Glitchyi/keybaord/design/concepts/navy-lighting-v4-usb-flush/rear-usb-flush-closeup.png

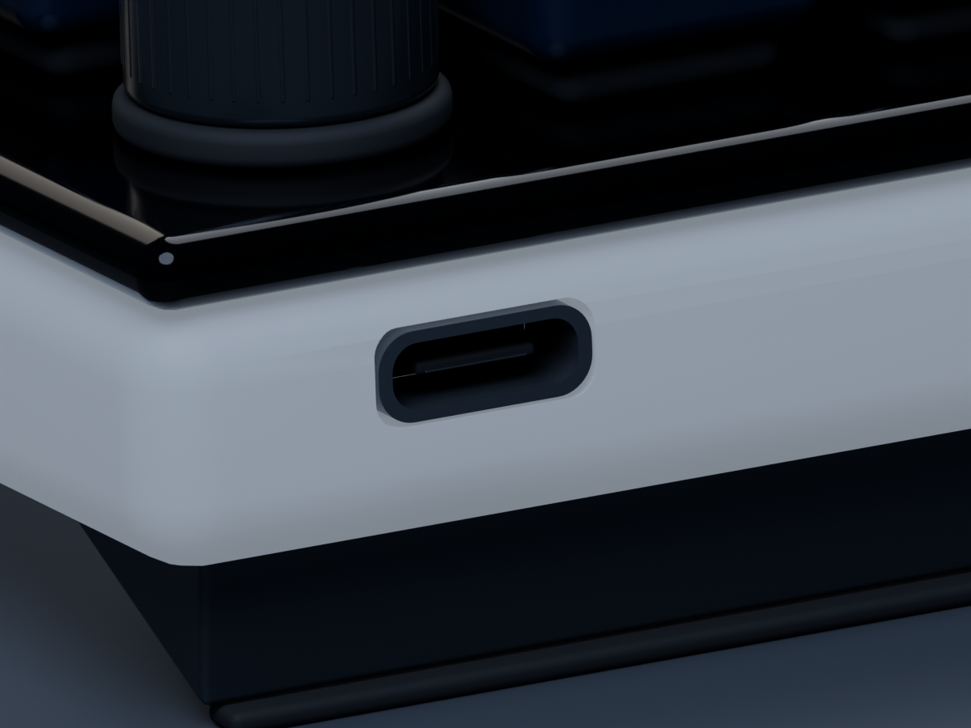
design/concepts/navy-lighting-v4-usb-flush/rear-usb-flush-closeup.png
