Glitchyi/keybaord/design/concepts/navy-lighting-v4/navy-lighting-v4.png

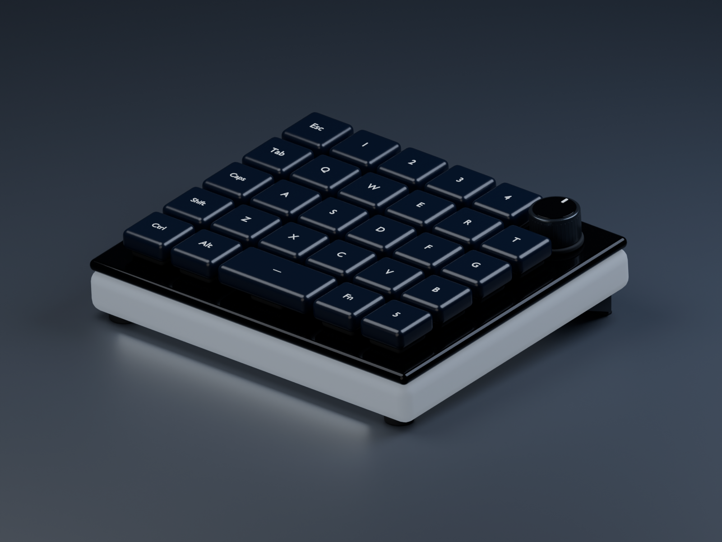
design/concepts/navy-lighting-v4/navy-lighting-v4.png
