Glitchyi/keybaord/design/fit-v1/rear-usb.png

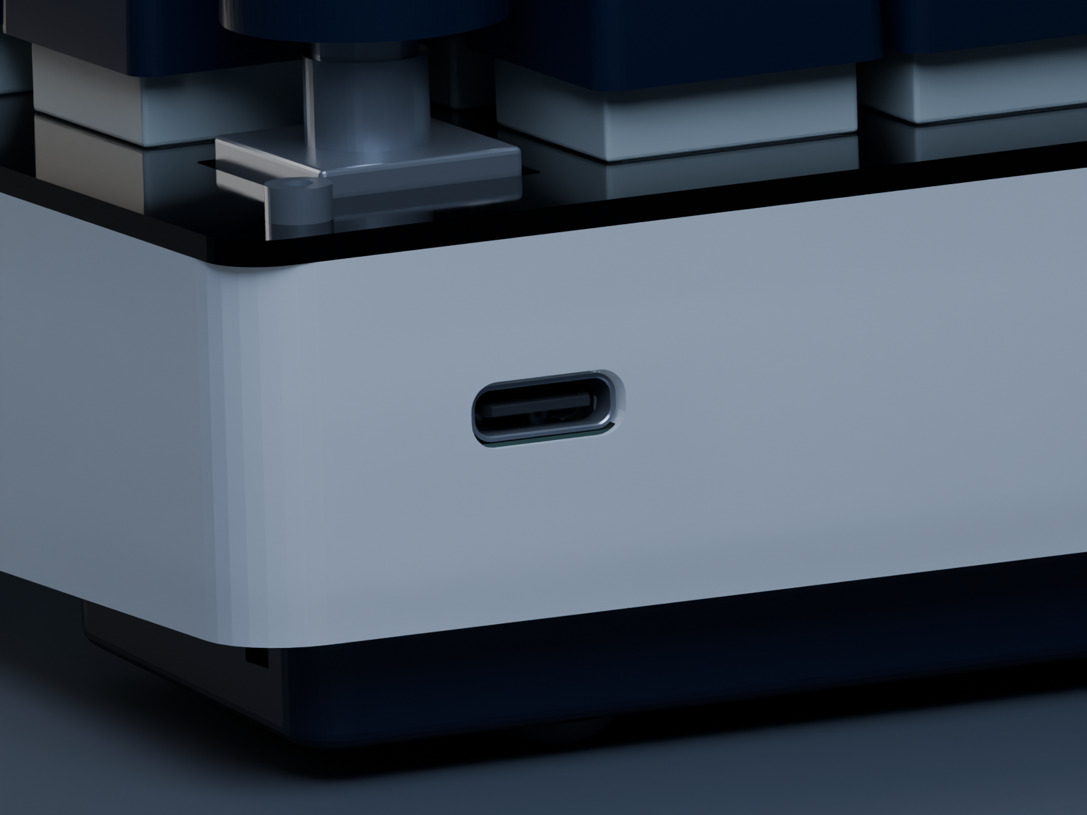
design/fit-v1/rear-usb.png
