Glitchyi/keybaord/design/fit-v1/section.png

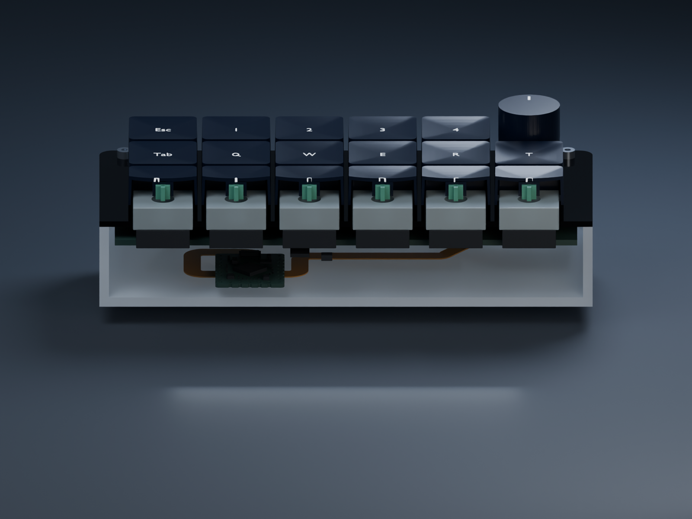
design/fit-v1/section.png
