Glitchyi/keybaord/design/fit-v1/underside.png

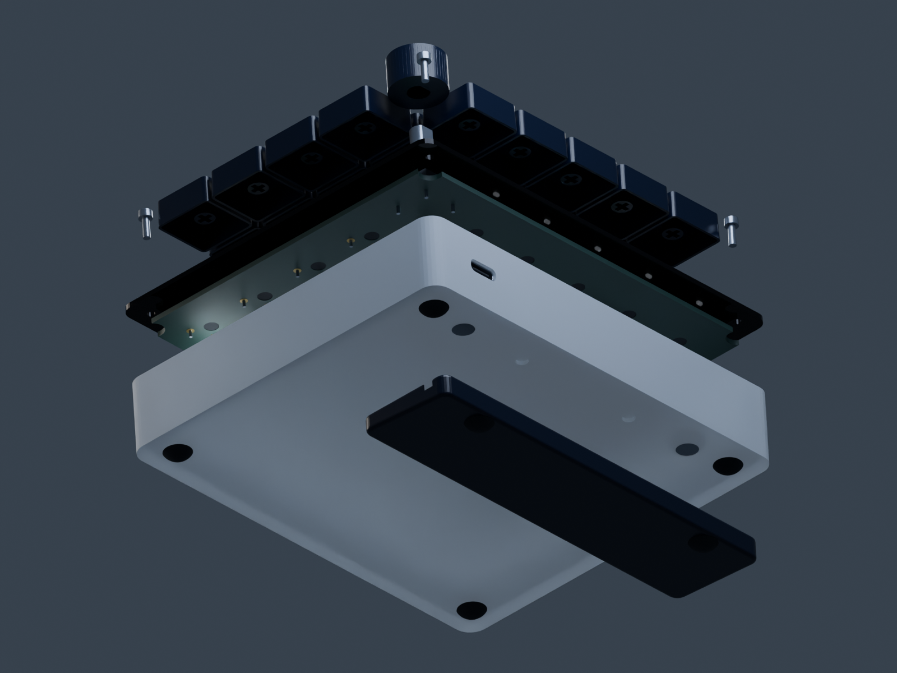
design/fit-v1/underside.png
