Glitchyi/keybaord/procurement/evidence/robu-four-models-2026-10-18.png

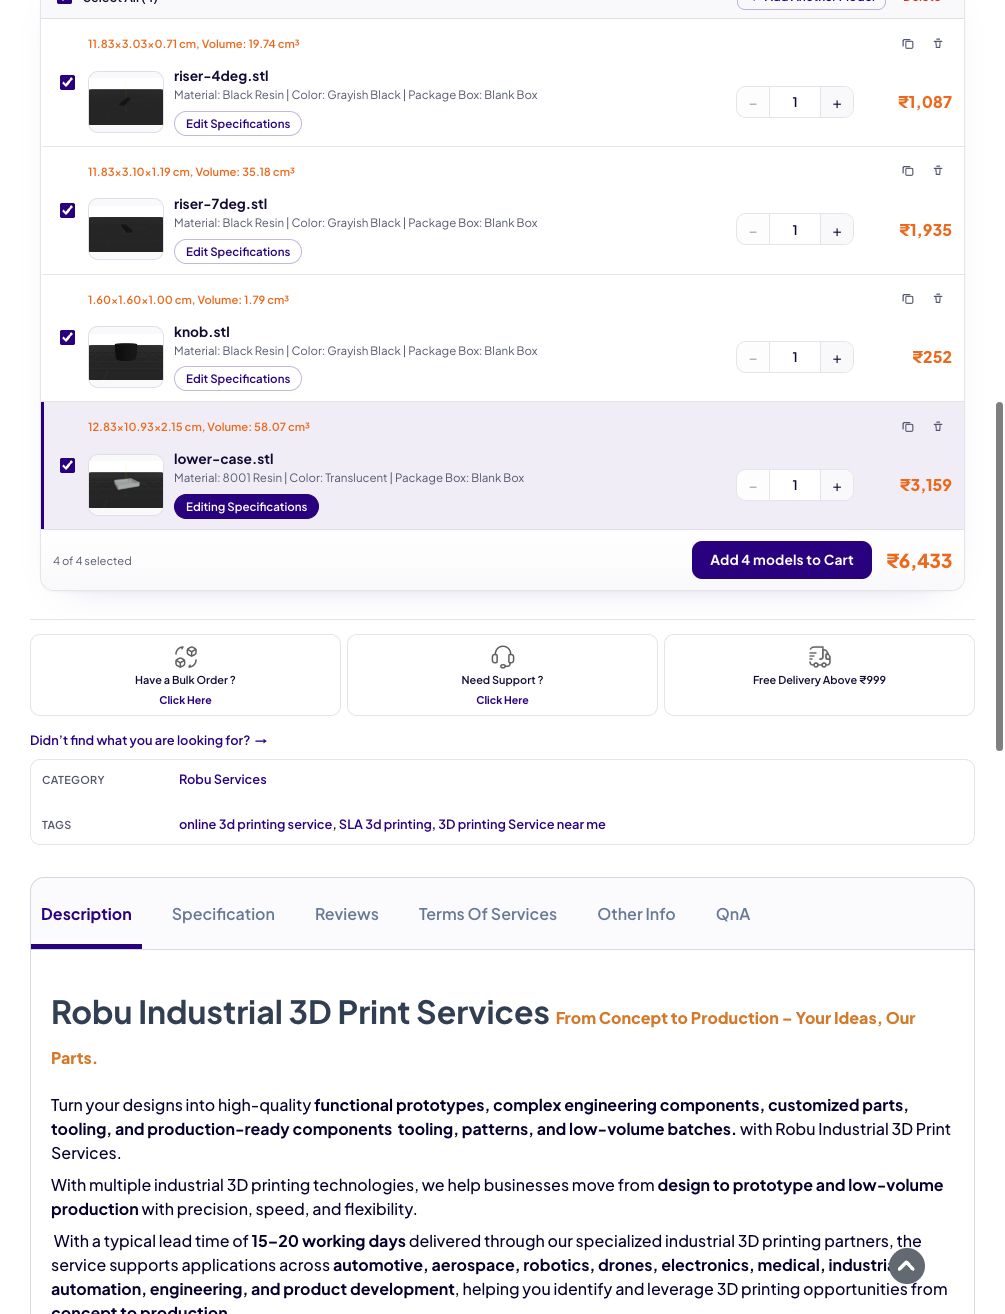
procurement/evidence/robu-four-models-2026-10-18.png
