Glitchyi/keybaord/docs/full-keyboard-cost-audit.md

# Full keyboard cost audit — 18 October 2026

The working-keyboard bill is **incomplete**. Budget **one 4° riser provisionally**, preserve the 7° model/quote as an alternative, and exclude its cost from the selected build. This procurement selection does not revise the frozen dimensional model or its historical BOM. No purchase, substitution, physical-fit or diffusion approval follows from this audit.

## Amounts currently supported

| Scope | Amount, INR | Evidence and limitation |
| --- | ---: | --- |
| Lower case, translucent SLA | 3,159 | Robu live calculator, GST included; heavy frosting and manufacturing changes excluded. |
| Knob, black SLA | 252 | Robu live calculator, GST included; navy finish/index and fit review excluded. |
| **One 4° riser body**, black SLA | **1,087** | Robu live calculator, GST included; magnets, feet and positive capture pieces excluded. |
| **Selected three-print estimate** | **4,498** | Sum of the three rows above; excludes delivery and the unquoted lines below. |
| 7° riser body, alternative only | 1,935 | Keep as an alternative. Selecting it instead gives a three-print estimate of ₹5,346; never count both in a one-riser build. |
| 30 BOX Jade switches, three ten-packs | 840 | Meckeys rechecked today: ₹280 per ten-pack, GST included, in stock. 28 installed, two spares; consumed value ₹784, spare value ₹56. |
| **Selected prints plus switch purchase only** | **5,338** | Cross-supplier partial amount including listed GST, excluding all other required costs. **Not a working-keyboard total or delivered quote.** |
| RP2040-Tiny kit listing | 513.30 | Hubtronics rechecked today: ₹435 +18% GST, **zero stock**. Reference only; availability and delivered procurement cost unresolved. |
| 28 Robu Vishay diodes, packaging alternative | 224 | Earlier actual UI evidence: ₹8 each at 1–49, GST included. Selected BOM is `1N4148W-E3-08`; Robu listing is `-18`. Not an approved substitution; exclude from selected subtotal. |

The four-upload Robu evidence remains ₹6,433 because it records both riser quotations. The new purchasing scope is ₹4,498 for three bodies. Neither amount covers the complete enclosure assembly. See [quote data](../procurement/robu-estimates.json), [actual supplier screenshot](../procurement/evidence/robu-four-models-2026-10-18.png) and [manufacturing findings](robu-quote-status.md). The dynamic calculator results cannot be recovered from an ordinary static product-page fetch; the dated UI capture is the evidence.

Current listing sources: [Robu industrial printing](https://robu.in/product/industrial-3d-printing/), [Meckeys BOX Jade, pack of ten](https://meckeys.com/shop/accessories/keyboard-accessories/key-switches/kailh-box-jade-switch/), [Hubtronics complete Tiny kit](https://hubtronics.in/rp2040-tiny-kit), [Robu diode alternative](https://robu.in/product/1n4148w-e3-18-vishay-1n4148w-e3-18-small-signal-diode-single-100-v-150-ma-1-2-v-4-ns-2-a/). The old ₹1,353.30 component subtotal remains historical evidence; it includes the unavailable kit and must not be mistaken for available stock or added again on top of the ₹840 switch line.

## Required bill for one working keyboard

Quantities below are consumption for one build with one riser. Exact purchased SKUs and design counts come from [the parts contract](../spec/parts.json), [assembly contract](../spec/keypad.json) and [custom-piece export](../procurement/robu/quote-parts.csv). Every unpriced row requires a supplier quote or explicit owner-supplied declaration; unknown does not mean zero.

| Required group | One-build quantity / selection | What the quote still needs |
| --- | --- | --- |
| Clicky switches | 28 Kailh BOX Jade `CPG1511F01S11-1` | ₹840 cash purchase buys 30; delivery and current stock at ordering. Soldered design: no hot-swap sockets required. |
| Keycaps and readable white legends | 27 custom 1u +one custom 2u Space, 28 translucent legend sets | Stem/BOX compatibility sample; viable material/process; dark navy colour and opacity; translucent white legends; finishing, bonding/assembly and rejects. Price the finished set, not 28 uncoloured shells alone. |
| Space stabilizer | One complete CHERRY `G99-0742` 2u mechanism | Exact matching housings, stems, wire and mounting method; availability/pack quantity, assembly and lubrication if used. No generic replacement approved. |
| Glossy top/support plate | One 1.5 mm plate, mirror black finish | Material and cutting process, switch-hole tolerances/edge finish, coating/polishing and flatness. Lower-case quote excludes this plate. |
| Lower case and knob | One each | Existing calculator body estimates only; redesign and final dimensions/process acceptance, heavy-frost treatment, navy knob finish and white index, fit samples. |
| Riser attachment and desk contacts | One 4° body; **four magnets**, **six rubber feet**, **four positive magnet closures** | Two case magnets +two bar magnets; four case feet +two bar feet. Selected references: K&J D42 and 3M SJ5302. Quote closures after redesign; existing thin capture rings are not manufacturing-ready. |
| Structural/USB retention | Six M2×6 screws +six M2 nuts; two USB retaining clamps | Four enclosure screws +two external USB clamp screws. Confirm final stack/length, nut capture and clamp material; include adhesives/insulation where the released design needs them. Do not invent holes through the adapter board. |
| Controller and internal USB link | One Waveshare RP2040-Tiny V1.1 **kit** | Main module, remote USB-C board and supplied approximately 150 mm eight-pin FPC are already included in the kit listing; do not buy/charge them twice. Confirm actual stock and included contents. |
| Encoder | One Bourns `PEC11R-4215F-S0024` | Exact shaft/push variant, distributor MOQ/cut-tape and any required securing hardware. Knob is a separate custom body. |
| Matrix diodes | 28 Vishay `1N4148W-E3-08` | Selected suffix stock, small-quantity packaging and spares. Keep ₹224 Robu `-18` listing as an alternative pending review. |
| White per-key lights | 28 Kingbright `APT1608QWF/D` +one Lumissil `IS31FL3236-QFLS2-TR` | Exact package stock/MOQ, support circuit, soldering and optical samples. This baseline has white per-key PWM, with RGB ambient lighting; per-key RGB is a separate unquoted variant. |
| Ambient lighting and data interface | 14 installed pixels from Adafruit 2969 +one TI `SN74AHCT1G125DBVR` | Purchased strip is one 1 m reel, not only the approximately 97.22 mm consumed segment. Quote connectors/pigtails, wire, insulation and attachment. No delivered INR strip quote yet. |
| Supporting electronics | Values/counts not yet released | LED-driver current-setting resistor, I²C pullups, bypass/bulk capacitors, buffer decoupling and enable bias; RGB data resistor and suitable power buffering; encoder input filtering if needed. Do not add 28 arbitrary LED resistors to a constant-current-driver circuit. |
| Power and external USB | One **data-capable** USB-C cable; protection and power components after review | Verify plug overmould against flush port, USB-C CC behaviour on the existing adapter, ESD/TVS coverage, VBUS current limiting/fusing, inrush, suspend and backfeed handling. Check existing module schematic before adding duplicate parts. Do not assume an external supply or USB-PD board is required. |
| Custom PCB and assembly | One populated keyboard PCB installed; purchased batch unknown | Complete schematic/routing, released Gerbers/drill files, BOM and placement file; fab minimum quantity, exact 1.5 mm stack, finish, stencil, sourcing, assembly setup/labour, inspection/rework and electrical testing. No PCB price is established. |
| Firmware and Windows volume sync | One tested firmware build +helper | Matrix/debounce, encoder/modifiers, remapping/macros/profile persistence, independent white brightness/effects, ambient/current limit, USB boot/recovery, host volume/mute sync and reconnect/default-device handling. Engineering effort or commissioned cost is unquoted, not zero. |
| Bring-up, samples and delivery | Per prototype programme | Socket/plate, stabilizer, port/clamp, magnetic-joint and diffuser coupons; solder/reflow supplies, tools or assembly service, light/current measurements, iteration/reprints, packing, supplier freight and any import/clearance charges. |

## Critical decisions before a firm total

1. **Close electronics and power before PCB release.** The selected driver has 36 independently controlled constant-current PWM channels; its external current-setting resistor and support circuit belong in the BOM. Its Rev H revision history records an **NRND watermark** added in 2021: obtain lifecycle/stock confirmation and review suitability before release, without silently changing the part. The manufacturer's reel quantity is not a one-off distributor MOQ. [Lumissil datasheet, application circuit, ordering information and revision history](https://www.lumissil.com/assets/pdf/core/IS31FL3236_DS.pdf).
2. **Set a usable USB lighting limit.** Adafruit specifies up to 60 mA per pixel for this strip. Fourteen pixels therefore give a conservative **840 mA strip-only maximum**, before white keys/controller. This arithmetic is a power-design warning, not measured use; define brightness/current limiting and verify the actual port/cable budget. The strip guide also identifies data resistance, buffering and level shifting; final component values/volume must suit this small enclosure. [Strip specification](https://www.adafruit.com/product/2969), [wiring practices](https://learn.adafruit.com/adafruit-neopixel-uberguide/best-practices), [selected TI buffer](https://www.ti.com/product/SN74AHCT1G125).
3. **Quote a manufacture-ready revision.** Existing caps, USB skin, nut-trap walls, clamps/capture rings and material interfaces need review/redesign; frozen geometry is a cost study. Validate samples for full switch travel, stem fit, 2u movement, retention and diffusion. Robu publishes process guidance, but a calculator price does not accept these interfaces. [Local manufacturing audit](../procurement/robu/README.md), [Robu printing guide](https://robu.in/3d-printing-guide/).
4. **Resolve PCB thickness and files.** Recorded Robu calculator refused a price without Gerbers and offered 1.6 mm rather than the model's 1.5 mm. Ask for the selected stack or revalidate the stabilizer/mechanical stack before accepting an alternative. Quote the actual batch separately from one-board consumption. [Recorded calculator result](robu-quote-status.md), [Robu PCB service](https://robu.in/product/online-pcb-manufacturing-service/).
5. **Count software as delivery work.** QMK Raw HID supports bidirectional host communication and requires a host program; Windows endpoint-volume callbacks can supply real volume changes. This supports the accepted helper approach but is not implemented keyboard firmware or a tested Windows app. [QMK Raw HID](https://docs.qmk.fm/features/rawhid), [Microsoft endpoint volume notifications](https://learn.microsoft.com/en-us/windows/win32/coreaudio/endpoint-volume-controls).

## Purchase-budget rules and quote completion

Keep three separate figures: **one-keyboard materials consumed**, **prototype cash spend** (packs/MOQs/spares, complete strip reel, PCB batch, freight and taxes), and **development/validation cost** (engineering, samples, tools and rework). Do not amortize a five-board purchase into one fifth of the money needed to build the first unit. Existing owned tools/materials need an explicit declaration before treating their additional cash spend as zero. No speculative percentage contingency is presented as a supplier quote.

For every unpriced line obtain: exact part/material/revision, installed quantity, purchasable quantity/pack/MOQ, unit and extended INR prices, GST included/excluded, availability, delivery destination/freight, import/clearance if applicable, lead time, assembly/finishing inclusion, quote expiry, and accepted tolerances/DFM exceptions. Add GST once; never apply it again to the Robu/Meckeys inclusive figures. Deduplicate kit contents and supplier/assembly turnkey component charges.

**Optional, separate from the base working-keyboard bill:** profile sheets (forming/tooling, opaque masking and printed icons, knob notch, key-travel trials), per-sheet identification tags and reader/antenna/support circuitry, plus profile-detection firmware. Automatic NFC switching and formed overlays remain concepts. The alternate 7° bar and per-key RGB comparison also remain separate options, not extra mandatory cost. No exact optional hardware or price is selected here.
