Glitchyi/keybaord/procurement/robu-purchased-parts.csv

Manufacturer | MPN | Quantity | Description | Substitution policy
Kailh | CPG1511F01S11-1 | 30 | BOX Jade standard-height soldered clicky switch | Exact code preferred; list any alternative separately for dimensional review
CHERRY | G99-0742 | 1 | 2u PCB-mounted leveling mechanism | Exact code preferred; list any alternative separately for dimensional review
Waveshare | RP2040-Tiny V1.1 | 1 | RP2040-Tiny main controller module | Quote full V1.1 kit including adapter and supplied FPC; do not double charge
Bourns | PEC11R-4215F-S0024 | 1 | Rotary encoder with push switch | Exact code preferred; list any alternative separately for dimensional review
Kingbright | APT1608QWF/D | 28 | Top-emitting white per-key LED | Exact code preferred; list any alternative separately for dimensional review
Lumissil | IS31FL3236-QFLS2-TR | 1 | 36-channel white LED PWM driver | Exact code preferred; list any alternative separately for dimensional review
Adafruit | 2969 | 1 | Base RGB LED strip, white flex PCB | Exact code preferred; list any alternative separately for dimensional review
Texas Instruments | SN74AHCT1G125DBVR | 1 | 5V RGB data logic buffer | Exact code preferred; list any alternative separately for dimensional review
K&J Magnetics | D42 | 4 | Captive riser attachment disc magnet | Exact code preferred; list any alternative separately for dimensional review
3M | SJ5302 / 7100006189 | 6 | Clear hemispherical adhesive contact foot | Exact code preferred; list any alternative separately for dimensional review
RS PRO | 293-280 | 6 | M2 x 6 socket cap enclosure screw | Exact code preferred; list any alternative separately for dimensional review
RS PRO | 248-4551 | 6 | M2 captive hex nut | Exact code preferred; list any alternative separately for dimensional review
Vishay | 1N4148W-E3-08 | 28 | Per-key matrix anti-ghosting diode | Exact code preferred; list any alternative separately for dimensional review
