Glitchyi/keybaord/procurement/robu/quote-parts.csv

id | file | quantity | width_mm | depth_mm | height_mm | volume_mm3 | closed_manifold | components | instant_budgetary_candidate | print_ready | thin_features
lower-case | stl/lower-case.stl | 1 | 128.3000030517578 | 109.25 | 21.5 | 58068.742442588016 | True | 1 | False | False | [{"feature": "rear USB blind-pocket outer skin", "mm": 0.5230941785257641, "kind": "wall", "status": "below-provider-minimum"}, {"feature": "support-post hex nut trap minimum radial wall", "mm": 0.20965881556564625, "kind": "wall", "status": "below-provider-minimum"}]
plate | stl/plate.stl | 1 | 128.3000030517578 | 109.25 | 1.5 | 12117.9266763235 | True | 1 | False | False | [{"feature": "plate thickness", "mm": 1.5, "kind": "wall", "status": "below-size-based-2mm-wall-minimum"}]
riser-4deg | stl/riser-4deg.stl | 1 | 118.30000305175781 | 30.0 | 7.536687850952148 | 19738.783353551342 | True | 1 | True | False | [{"feature": "locating key height", "mm": 0.8, "kind": "raised feature", "status": "at-provider-thinnest-feature-limit"}]
riser-7deg | stl/riser-7deg.stl | 1 | 118.30000305175781 | 30.0 | 12.637569427490234 | 35178.30528715591 | True | 1 | True | False | [{"feature": "locating key height", "mm": 0.8, "kind": "raised feature", "status": "at-provider-thinnest-feature-limit"}]
knob | stl/knob.stl | 1 | 16.040002822875977 | 16.03999900817871 | 10.0 | 1788.228755772041 | True | 1 | False | False | [{"feature": "grip cylinder diameter before union", "mm": 0.24, "kind": "surface detail", "status": "below-provider-thinnest-feature-limit"}, {"feature": "approximate grip proudness after union", "mm": 0.02, "kind": "surface detail", "status": "supplier-detail-review-required"}]
cap-1u-esc | stl/cap-1u-esc.stl | 1 | 18.0 | 18.0 | 7.799999713897705 | 680.1541374379751 | False | 1 | False | False | [{"feature": "nominal side wall", "mm": 0.7, "kind": "wall", "status": "below-provider-minimum"}, {"feature": "nominal boss-to-cross-tip radial wall", "mm": 0.75, "kind": "wall", "status": "below-provider-minimum"}]
legend-esc | stl/legend-esc.stl | 1 | 3.881600022315979 | 2.2112001180648804 | 1.0340137481689453 | 3.01592424188986 | False | 3 | False | False | [{"feature": "glyph stroke minimum", "mm": null, "kind": "surface detail", "status": "not-fully-measured; sub-0.8mm nominal glyph strokes and disconnected islands require redesign or process review"}]
cap-1u-1 | stl/cap-1u-1.stl | 1 | 18.0 | 18.0 | 7.799999713897705 | 682.067935476108 | True | 1 | False | False | [{"feature": "nominal side wall", "mm": 0.7, "kind": "wall", "status": "below-provider-minimum"}, {"feature": "nominal boss-to-cross-tip radial wall", "mm": 0.75, "kind": "wall", "status": "below-provider-minimum"}]
legend-1 | stl/legend-1.stl | 1 | 0.31360001862049103 | 2.182400107383728 | 1.0166683197021484 | 0.6839513521072044 | True | 1 | False | False | [{"feature": "glyph stroke minimum", "mm": null, "kind": "surface detail", "status": "not-fully-measured; sub-0.8mm nominal glyph strokes and disconnected islands require redesign or process review"}]
cap-1u-2 | stl/cap-1u-2.stl | 1 | 18.0 | 18.0 | 7.799999713897705 | 681.6416930399932 | True | 1 | False | False | [{"feature": "nominal side wall", "mm": 0.7, "kind": "wall", "status": "below-provider-minimum"}, {"feature": "nominal boss-to-cross-tip radial wall", "mm": 0.75, "kind": "wall", "status": "below-provider-minimum"}]
legend-2 | stl/legend-2.stl | 1 | 1.3824000358581543 | 2.2112001180648804 | 1.016815185546875 | 1.2079902402960299 | True | 1 | False | False | [{"feature": "glyph stroke minimum", "mm": null, "kind": "surface detail", "status": "not-fully-measured; sub-0.8mm nominal glyph strokes and disconnected islands require redesign or process review"}]
cap-1u-3 | stl/cap-1u-3.stl | 1 | 18.0 | 18.0 | 7.799999713897705 | 681.6701704955516 | False | 1 | False | False | [{"feature": "nominal side wall", "mm": 0.7, "kind": "wall", "status": "below-provider-minimum"}, {"feature": "nominal boss-to-cross-tip radial wall", "mm": 0.75, "kind": "wall", "status": "below-provider-minimum"}]
legend-3 | stl/legend-3.stl | 1 | 1.152000069618225 | 2.2400001287460327 | 1.0170612335205078 | 1.1738812993755259 | False | 1 | False | False | [{"feature": "glyph stroke minimum", "mm": null, "kind": "surface detail", "status": "not-fully-measured; sub-0.8mm nominal glyph strokes and disconnected islands require redesign or process review"}]
cap-1u-4 | stl/cap-1u-4.stl | 1 | 18.0 | 18.0 | 7.799999713897705 | 681.6222310912216 | True | 1 | False | False | [{"feature": "nominal side wall", "mm": 0.7, "kind": "wall", "status": "below-provider-minimum"}, {"feature": "nominal boss-to-cross-tip radial wall", "mm": 0.75, "kind": "wall", "status": "below-provider-minimum"}]
legend-4 | stl/legend-4.stl | 1 | 1.4720000624656677 | 2.2112001180648804 | 1.0170612335205078 | 1.23612593177254 | True | 1 | False | False | [{"feature": "glyph stroke minimum", "mm": null, "kind": "surface detail", "status": "not-fully-measured; sub-0.8mm nominal glyph strokes and disconnected islands require redesign or process review"}]
cap-1u-tab | stl/cap-1u-tab.stl | 1 | 18.0 | 18.0 | 7.799999713897705 | 679.866522979043 | True | 1 | False | False | [{"feature": "nominal side wall", "mm": 0.7, "kind": "wall", "status": "below-provider-minimum"}, {"feature": "nominal boss-to-cross-tip radial wall", "mm": 0.75, "kind": "wall", "status": "below-provider-minimum"}]
legend-tab | stl/legend-tab.stl | 1 | 4.736000061035156 | 2.2112001180648804 | 1.0477237701416016 | 3.3554368561610906 | True | 3 | False | False | [{"feature": "glyph stroke minimum", "mm": null, "kind": "surface detail", "status": "not-fully-measured; sub-0.8mm nominal glyph strokes and disconnected islands require redesign or process review"}]
cap-1u-q | stl/cap-1u-q.stl | 1 | 18.0 | 18.0 | 7.799999713897705 | 680.9428715990439 | True | 1 | False | False | [{"feature": "nominal side wall", "mm": 0.7, "kind": "wall", "status": "below-provider-minimum"}, {"feature": "nominal boss-to-cross-tip radial wall", "mm": 0.75, "kind": "wall", "status": "below-provider-minimum"}]
legend-q | stl/legend-q.stl | 1 | 2.253968596458435 | 2.653970718383789 | 1.015726089477539 | 2.0665585156953146 | True | 1 | False | False | [{"feature": "glyph stroke minimum", "mm": null, "kind": "surface detail", "status": "not-fully-measured; sub-0.8mm nominal glyph strokes and disconnected islands require redesign or process review"}]
cap-1u-w | stl/cap-1u-w.stl | 1 | 18.0 | 18.0 | 7.799999713897705 | 680.7621568464621 | True | 1 | False | False | [{"feature": "nominal side wall", "mm": 0.7, "kind": "wall", "status": "below-provider-minimum"}, {"feature": "nominal boss-to-cross-tip radial wall", "mm": 0.75, "kind": "wall", "status": "below-provider-minimum"}]
legend-w | stl/legend-w.stl | 1 | 3.3312000036239624 | 2.201600134372711 | 1.019230842590332 | 2.285960918970504 | True | 1 | False | False | [{"feature": "glyph stroke minimum", "mm": null, "kind": "surface detail", "status": "not-fully-measured; sub-0.8mm nominal glyph strokes and disconnected islands require redesign or process review"}]
cap-1u-e | stl/cap-1u-e.stl | 1 | 18.0 | 18.0 | 7.799999713897705 | 681.4350700275222 | True | 1 | False | False | [{"feature": "nominal side wall", "mm": 0.7, "kind": "wall", "status": "below-provider-minimum"}, {"feature": "nominal boss-to-cross-tip radial wall", "mm": 0.75, "kind": "wall", "status": "below-provider-minimum"}]
legend-e | stl/legend-e.stl | 1 | 1.2672000527381897 | 2.182400107383728 | 1.0166683197021484 | 1.4635906341940783 | True | 1 | False | False | [{"feature": "glyph stroke minimum", "mm": null, "kind": "surface detail", "status": "not-fully-measured; sub-0.8mm nominal glyph strokes and disconnected islands require redesign or process review"}]
cap-1u-r | stl/cap-1u-r.stl | 1 | 18.0 | 18.0 | 7.799999713897705 | 681.2685738867676 | True | 1 | False | False | [{"feature": "nominal side wall", "mm": 0.7, "kind": "wall", "status": "below-provider-minimum"}, {"feature": "nominal boss-to-cross-tip radial wall", "mm": 0.75, "kind": "wall", "status": "below-provider-minimum"}]
legend-r | stl/legend-r.stl | 1 | 1.6864001154899597 | 2.182400107383728 | 1.0166683197021484 | 1.6707669657692252 | True | 1 | False | False | [{"feature": "glyph stroke minimum", "mm": null, "kind": "surface detail", "status": "not-fully-measured; sub-0.8mm nominal glyph strokes and disconnected islands require redesign or process review"}]
cap-1u-t | stl/cap-1u-t.stl | 1 | 18.0 | 18.0 | 7.799999713897705 | 681.7213979588009 | True | 1 | False | False | [{"feature": "nominal side wall", "mm": 0.7, "kind": "wall", "status": "below-provider-minimum"}, {"feature": "nominal boss-to-cross-tip radial wall", "mm": 0.75, "kind": "wall", "status": "below-provider-minimum"}]
legend-t | stl/legend-t.stl | 1 | 1.8240001201629639 | 2.182400107383728 | 1.0166683197021484 | 1.1087397911525652 | True | 1 | False | False | [{"feature": "glyph stroke minimum", "mm": null, "kind": "surface detail", "status": "not-fully-measured; sub-0.8mm nominal glyph strokes and disconnected islands require redesign or process review"}]
cap-1u-caps | stl/cap-1u-caps.stl | 1 | 18.0 | 18.0 | 7.799999713897705 | 680.0088977870846 | True | 1 | False | False | [{"feature": "nominal side wall", "mm": 0.7, "kind": "wall", "status": "below-provider-minimum"}, {"feature": "nominal boss-to-cross-tip radial wall", "mm": 0.75, "kind": "wall", "status": "below-provider-minimum"}]
legend-caps | stl/legend-caps.stl | 1 | 5.216400384902954 | 2.486700177192688 | 1.0591402053833008 | 3.160630848309758 | True | 4 | False | False | [{"feature": "glyph stroke minimum", "mm": null, "kind": "surface detail", "status": "not-fully-measured; sub-0.8mm nominal glyph strokes and disconnected islands require redesign or process review"}]
cap-1u-a | stl/cap-1u-a.stl | 1 | 18.0 | 18.0 | 7.799999713897705 | 681.3776001577571 | True | 1 | False | False | [{"feature": "nominal side wall", "mm": 0.7, "kind": "wall", "status": "below-provider-minimum"}, {"feature": "nominal boss-to-cross-tip radial wall", "mm": 0.75, "kind": "wall", "status": "below-provider-minimum"}]
legend-a | stl/legend-a.stl | 1 | 2.1344001293182373 | 2.195200204849243 | 1.0163211822509766 | 1.5368594594326923 | True | 1 | False | False | [{"feature": "glyph stroke minimum", "mm": null, "kind": "surface detail", "status": "not-fully-measured; sub-0.8mm nominal glyph strokes and disconnected islands require redesign or process review"}]
cap-1u-s | stl/cap-1u-s.stl | 1 | 18.0 | 18.0 | 7.799999713897705 | 681.6233228068354 | True | 1 | False | False | [{"feature": "nominal side wall", "mm": 0.7, "kind": "wall", "status": "below-provider-minimum"}, {"feature": "nominal boss-to-cross-tip radial wall", "mm": 0.75, "kind": "wall", "status": "below-provider-minimum"}]
legend-s | stl/legend-s.stl | 1 | 1.2352001070976257 | 2.2400001287460327 | 1.0170612335205078 | 1.2316331088572168 | True | 1 | False | False | [{"feature": "glyph stroke minimum", "mm": null, "kind": "surface detail", "status": "not-fully-measured; sub-0.8mm nominal glyph strokes and disconnected islands require redesign or process review"}]
cap-1u-d | stl/cap-1u-d.stl | 1 | 18.0 | 18.0 | 7.799999713897705 | 681.0621021248455 | True | 1 | False | False | [{"feature": "nominal side wall", "mm": 0.7, "kind": "wall", "status": "below-provider-minimum"}, {"feature": "nominal boss-to-cross-tip radial wall", "mm": 0.75, "kind": "wall", "status": "below-provider-minimum"}]
legend-d | stl/legend-d.stl | 1 | 2.0096001625061035 | 2.182400107383728 | 1.0095062255859375 | 1.91802956997474 | True | 1 | False | False | [{"feature": "glyph stroke minimum", "mm": null, "kind": "surface detail", "status": "not-fully-measured; sub-0.8mm nominal glyph strokes and disconnected islands require redesign or process review"}]
cap-1u-f | stl/cap-1u-f.stl | 1 | 18.0 | 18.0 | 7.799999713897705 | 681.6792822152082 | True | 1 | False | False | [{"feature": "nominal side wall", "mm": 0.7, "kind": "wall", "status": "below-provider-minimum"}, {"feature": "nominal boss-to-cross-tip radial wall", "mm": 0.75, "kind": "wall", "status": "below-provider-minimum"}]
legend-f | stl/legend-f.stl | 1 | 1.1648001074790955 | 2.182400107383728 | 1.0158624649047852 | 1.1629103996072132 | True | 1 | False | False | [{"feature": "glyph stroke minimum", "mm": null, "kind": "surface detail", "status": "not-fully-measured; sub-0.8mm nominal glyph strokes and disconnected islands require redesign or process review"}]
cap-1u-g | stl/cap-1u-g.stl | 1 | 18.0 | 18.0 | 7.799999713897705 | 681.1816223405955 | True | 1 | False | False | [{"feature": "nominal side wall", "mm": 0.7, "kind": "wall", "status": "below-provider-minimum"}, {"feature": "nominal boss-to-cross-tip radial wall", "mm": 0.75, "kind": "wall", "status": "below-provider-minimum"}]
legend-g | stl/legend-g.stl | 1 | 1.9936001896858215 | 2.2400001287460327 | 1.0135536193847656 | 1.7718920526419626 | True | 1 | False | False | [{"feature": "glyph stroke minimum", "mm": null, "kind": "surface detail", "status": "not-fully-measured; sub-0.8mm nominal glyph strokes and disconnected islands require redesign or process review"}]
cap-1u-shift | stl/cap-1u-shift.stl | 1 | 18.0 | 18.0 | 7.799999713897705 | 680.0453637187546 | True | 1 | False | False | [{"feature": "nominal side wall", "mm": 0.7, "kind": "wall", "status": "below-provider-minimum"}, {"feature": "nominal boss-to-cross-tip radial wall", "mm": 0.75, "kind": "wall", "status": "below-provider-minimum"}]
legend-shift | stl/legend-shift.stl | 1 | 4.641300201416016 | 1.891100287437439 | 1.0490894317626953 | 3.136192671094232 | True | 6 | False | False | [{"feature": "glyph stroke minimum", "mm": null, "kind": "surface detail", "status": "not-fully-measured; sub-0.8mm nominal glyph strokes and disconnected islands require redesign or process review"}]
cap-1u-z | stl/cap-1u-z.stl | 1 | 18.0 | 18.0 | 7.799999713897705 | 681.2989623233683 | True | 1 | False | False | [{"feature": "nominal side wall", "mm": 0.7, "kind": "wall", "status": "below-provider-minimum"}, {"feature": "nominal boss-to-cross-tip radial wall", "mm": 0.75, "kind": "wall", "status": "below-provider-minimum"}]
legend-z | stl/legend-z.stl | 1 | 1.9680001735687256 | 2.182400107383728 | 1.0166683197021484 | 1.6293615222010742 | True | 1 | False | False | [{"feature": "glyph stroke minimum", "mm": null, "kind": "surface detail", "status": "not-fully-measured; sub-0.8mm nominal glyph strokes and disconnected islands require redesign or process review"}]
cap-1u-x | stl/cap-1u-x.stl | 1 | 18.0 | 18.0 | 7.799999713897705 | 681.3564509641292 | True | 1 | False | False | [{"feature": "nominal side wall", "mm": 0.7, "kind": "wall", "status": "below-provider-minimum"}, {"feature": "nominal boss-to-cross-tip radial wall", "mm": 0.75, "kind": "wall", "status": "below-provider-minimum"}]
legend-x | stl/legend-x.stl | 1 | 2.2528001070022583 | 2.182400107383728 | 1.0167427062988281 | 1.5626141437251997 | True | 1 | False | False | [{"feature": "glyph stroke minimum", "mm": null, "kind": "surface detail", "status": "not-fully-measured; sub-0.8mm nominal glyph strokes and disconnected islands require redesign or process review"}]
cap-1u-c | stl/cap-1u-c.stl | 1 | 18.0 | 18.0 | 7.799999713897705 | 681.4572156866587 | True | 1 | False | False | [{"feature": "nominal side wall", "mm": 0.7, "kind": "wall", "status": "below-provider-minimum"}, {"feature": "nominal boss-to-cross-tip radial wall", "mm": 0.75, "kind": "wall", "status": "below-provider-minimum"}]
legend-c | stl/legend-c.stl | 1 | 1.9680001735687256 | 2.2400001287460327 | 1.0103569030761719 | 1.4319431917388212 | True | 1 | False | False | [{"feature": "glyph stroke minimum", "mm": null, "kind": "surface detail", "status": "not-fully-measured; sub-0.8mm nominal glyph strokes and disconnected islands require redesign or process review"}]
cap-1u-v | stl/cap-1u-v.stl | 1 | 18.0 | 18.0 | 7.799999713897705 | 681.65509482699 | True | 1 | False | False | [{"feature": "nominal side wall", "mm": 0.7, "kind": "wall", "status": "below-provider-minimum"}, {"feature": "nominal boss-to-cross-tip radial wall", "mm": 0.75, "kind": "wall", "status": "below-provider-minimum"}]
legend-v | stl/legend-v.stl | 1 | 1.9328001737594604 | 2.201600134372711 | 1.0152912139892578 | 1.1942127790083028 | True | 1 | False | False | [{"feature": "glyph stroke minimum", "mm": null, "kind": "surface detail", "status": "not-fully-measured; sub-0.8mm nominal glyph strokes and disconnected islands require redesign or process review"}]
cap-1u-b | stl/cap-1u-b.stl | 1 | 18.0 | 18.0 | 7.799999713897705 | 681.1013525729745 | True | 1 | False | False | [{"feature": "nominal side wall", "mm": 0.7, "kind": "wall", "status": "below-provider-minimum"}, {"feature": "nominal boss-to-cross-tip radial wall", "mm": 0.75, "kind": "wall", "status": "below-provider-minimum"}]
legend-b | stl/legend-b.stl | 1 | 1.4976001381874084 | 2.182400107383728 | 1.0165739059448242 | 1.8760849660474328 | True | 1 | False | False | [{"feature": "glyph stroke minimum", "mm": null, "kind": "surface detail", "status": "not-fully-measured; sub-0.8mm nominal glyph strokes and disconnected islands require redesign or process review"}]
cap-1u-ctrl | stl/cap-1u-ctrl.stl | 1 | 18.0 | 18.0 | 7.799999713897705 | 680.6567387519121 | True | 1 | False | False | [{"feature": "nominal side wall", "mm": 0.7, "kind": "wall", "status": "below-provider-minimum"}, {"feature": "nominal boss-to-cross-tip radial wall", "mm": 0.75, "kind": "wall", "status": "below-provider-minimum"}]
legend-ctrl | stl/legend-ctrl.stl | 1 | 4.166100263595581 | 1.8900001049041748 | 1.0381536483764648 | 2.393544908292756 | True | 4 | False | False | [{"feature": "glyph stroke minimum", "mm": null, "kind": "surface detail", "status": "not-fully-measured; sub-0.8mm nominal glyph strokes and disconnected islands require redesign or process review"}]
cap-1u-alt | stl/cap-1u-alt.stl | 1 | 18.0 | 18.0 | 7.799999713897705 | 680.2755471142219 | True | 1 | False | False | [{"feature": "nominal side wall", "mm": 0.7, "kind": "wall", "status": "below-provider-minimum"}, {"feature": "nominal boss-to-cross-tip radial wall", "mm": 0.75, "kind": "wall", "status": "below-provider-minimum"}]
legend-alt | stl/legend-alt.stl | 1 | 3.897600293159485 | 2.2240002155303955 | 1.0292377471923828 | 2.876550506503566 | True | 3 | False | False | [{"feature": "glyph stroke minimum", "mm": null, "kind": "surface detail", "status": "not-fully-measured; sub-0.8mm nominal glyph strokes and disconnected islands require redesign or process review"}]
cap-2u-space | stl/cap-2u-space.stl | 1 | 37.04999923706055 | 18.0 | 7.799999713897705 | 1333.38315736413 | True | 1 | False | False | [{"feature": "nominal side wall", "mm": 0.7, "kind": "wall", "status": "below-provider-minimum"}, {"feature": "nominal boss-to-cross-tip radial wall", "mm": 0.75, "kind": "wall", "status": "below-provider-minimum"}]
legend-space | stl/legend-space.stl | 1 | 3.2576003074645996 | 0.20480003207921982 | 1.0099544525146484 | 0.666995535873118 | True | 1 | False | False | [{"feature": "glyph stroke minimum", "mm": null, "kind": "surface detail", "status": "not-fully-measured; sub-0.8mm nominal glyph strokes and disconnected islands require redesign or process review"}]
cap-1u-fn | stl/cap-1u-fn.stl | 1 | 18.0 | 18.0 | 7.799999713897705 | 680.9178309690748 | True | 1 | False | False | [{"feature": "nominal side wall", "mm": 0.7, "kind": "wall", "status": "below-provider-minimum"}, {"feature": "nominal boss-to-cross-tip radial wall", "mm": 0.75, "kind": "wall", "status": "below-provider-minimum"}]
legend-fn | stl/legend-fn.stl | 1 | 2.6624001264572144 | 2.182400107383728 | 1.0163698196411133 | 2.0931713798188696 | True | 2 | False | False | [{"feature": "glyph stroke minimum", "mm": null, "kind": "surface detail", "status": "not-fully-measured; sub-0.8mm nominal glyph strokes and disconnected islands require redesign or process review"}]
cap-1u-5 | stl/cap-1u-5.stl | 1 | 18.0 | 18.0 | 7.799999713897705 | 681.6204005210219 | True | 1 | False | False | [{"feature": "nominal side wall", "mm": 0.7, "kind": "wall", "status": "below-provider-minimum"}, {"feature": "nominal boss-to-cross-tip radial wall", "mm": 0.75, "kind": "wall", "status": "below-provider-minimum"}]
legend-5 | stl/legend-5.stl | 1 | 1.2416001558303833 | 2.2112001180648804 | 1.0158166885375977 | 1.2351959695410124 | True | 1 | False | False | [{"feature": "glyph stroke minimum", "mm": null, "kind": "surface detail", "status": "not-fully-measured; sub-0.8mm nominal glyph strokes and disconnected islands require redesign or process review"}]
usb-retaining-clamp | stl/usb-retaining-clamp.stl | 2 | 5.199999809265137 | 3.0 | 1.0 | 10.466499370473684 | True | 1 | False | False | [{"feature": "thickness", "mm": 1.0, "kind": "wall", "status": "below-provider-minimum"}]
magnet-capture-ring | stl/magnet-capture-ring.stl | 6 | 6.699999809265137 | 6.699999809265137 | 0.15000152587890625 | 0.9022058870402329 | True | 1 | False | False | [{"feature": "thickness", "mm": 0.15, "kind": "wall", "status": "below-provider-minimum"}, {"feature": "radial wall", "mm": 0.3, "kind": "wall", "status": "below-provider-minimum"}]
knob-index-white | stl/knob-index-white.stl | 1 | 0.6499999761581421 | 2.5 | 0.0800018310546875 | 0.12494366334777851 | False | 1 | False | False | [{"feature": "thickness", "mm": 0.08, "kind": "wall", "status": "below-provider-minimum"}]
