Glitchyi/keybaord/procurement/robu/stl/lower-case.stl

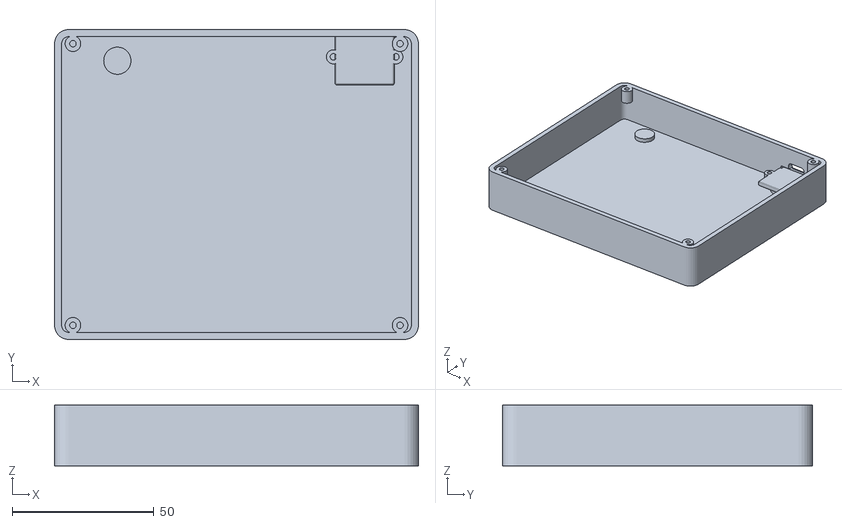
[picture p8: CAD file, 2026-10-18]
procurement/robu/stl/lower-case.stl
128.3 x 109.2 x 21.5
