Glitchyi/keybaord/procurement/robu/stl/knob.stl

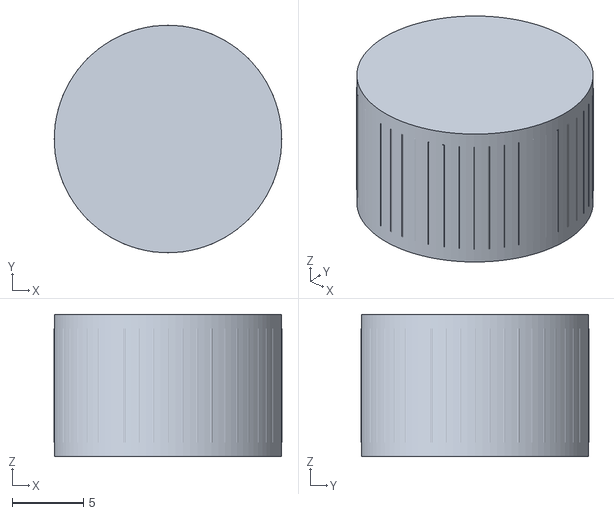
[picture p9: CAD file, 2026-10-18]
procurement/robu/stl/knob.stl
16.0 x 16.0 x 10.0
