Glitchyi/keybaord/procurement/robu/stl/riser-7deg.stl

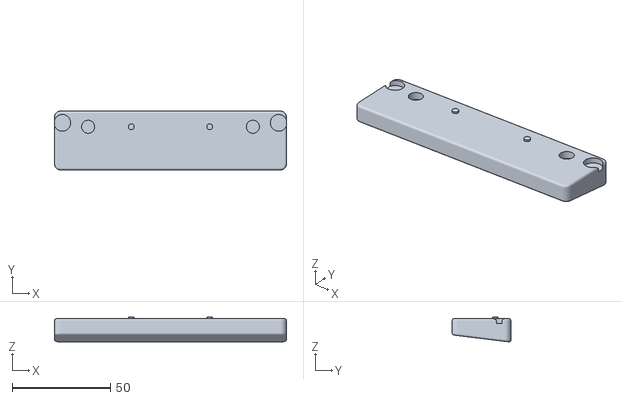
[picture p10: CAD file, 2026-10-18]
procurement/robu/stl/riser-7deg.stl
118.3 x 30.0 x 12.6
