Glitchyi/keybaord/procurement/robu/stl/riser-4deg.stl

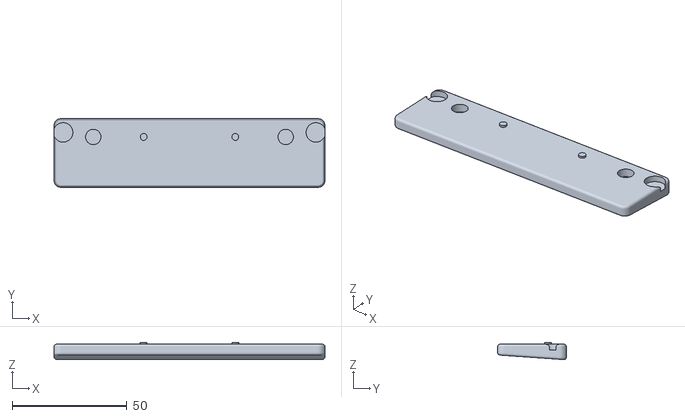
[picture p11: CAD file, 2026-10-18]
procurement/robu/stl/riser-4deg.stl
118.3 x 30.0 x 7.54
