Glitchyi/keybaord/(list of files, cad)

Other CAD files:
design/concepts/navy-lighting-v1/navy-lighting-v1.blend
design/concepts/navy-lighting-v2/navy-lighting-v2.blend
design/concepts/navy-lighting-v3/navy-lighting-v3.blend
design/concepts/navy-lighting-v4-usb-flush/navy-lighting-v4-usb-flush.blend
design/concepts/navy-lighting-v4/navy-lighting-v4.blend
design/fit-v1/keypad-fit-v1.blend
