Glitchyi/keybaord/design/fit-v1/assembled.png

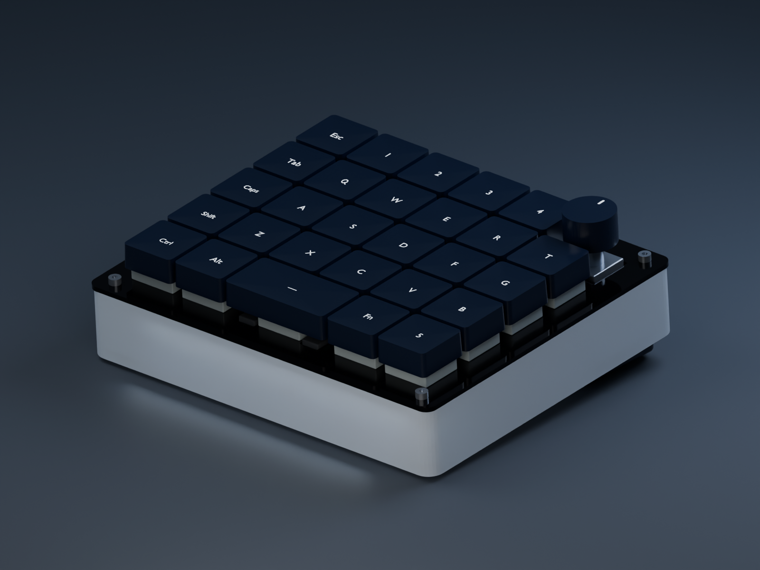
design/fit-v1/assembled.png
