Glitchyi/keybaord/(commit log)

2026-10-18 Build source-referenced keypad study and Pages homepage
    [keypad-fit-v1.blend, navy-lighting-v1.blend, navy-lighting-v2.blend, navy-lighting-v3.blend, navy-lighting-v4-usb-flush.blend, navy-lighting-v4.blend]
2026-10-18 Record Robu prototype estimates and manufacturing constraints
    [knob.stl, lower-case.stl, quote-parts.csv, riser-4deg.stl, riser-7deg.stl, robu-purchased-parts.csv]
2026-10-18 Budget one riser and audit complete keyboard costs
    [robu-purchased-parts.csv]
